vetlemt/DIC_project/(commit log)

2019-10-09 made the analog circuit in AIM-Spice
2019-11-13 upload digital part
    [compile.cfg, library.cfg, projlib.cfg]
